tenondra/fimu_pb170_project/doc/project_documentation.docx

PB170 Záverečný projekt

Ondřej Malanik

Andrej Lipták

Našim záverečným projektom je obvod, ktorý strieda 4 farby blikaním farebných LED. Pomocou tlačidla môže užívateľ prepínať medzi štyrmi rôznymi sekvenciami blikania. Obvod je zložený z dvoch hlavných častí: Mealyho automatu a počítadla s tlačidlom.

Sekvencie farieb:

1. Červená –> Zelená –> Modrá –> Žltá
2. Červená –> Modrá –> Žltá –> Zelená
3. Všetky –> Žiadne
4. Červená + Zelená –> Modrá + Žltá –> Červená + Modrá –> Zelená + Žltá

# Postup

## Mealyho automat

Prvým krokom pre postavenie funkčného Mealyho automatu je navrhnutie vstupov, na základe ktorých sa bude obvod prepínať do rôznych sekvencií. 4 vieme realizovať pomocou dvoch vstupných premenných, I1 a I2. Stavy vstupov označíme J, K, L a M.

| I1 | I2
J | 0 | 0
K | 0 | 1
L | 1 | 0
M | 1 | 1

Automat má pre každú farbu LED výstup, t.j. Red, Green, Blue a Yellow. Urobíme tabuľku požadovaných výstupných hodnôt pre každú farebnú kombináciu. ( A = All, N = None)

| R | G | B | Y | A | N | RG | BY | RB | GY
Red | 1 | 0 | 0 | 0 | 1 | 0 | 1 | 0 | 1 | 0
Green | 0 | 1 | 0 | 0 | 1 | 0 | 1 | 0 | 0 | 1
Blue | 0 | 0 | 1 | 0 | 1 | 0 | 0 | 1 | 1 | 0
Yellow | 0 | 0 | 0 | 1 | 1 | 0 | 0 | 1 | 0 | 1

Ďalej určíme vnútorné stavy automatu. Najprv si znázorníme zmeny farebných kombinácií v závislosti na vstupoch.

J | R–>G–>B–>Y
K | R–>B–>Y–>G
L | A–>N
M | RG–>BY–>RB–>GY

Pre uľahčenie si vstup L zmeníme na A–>N –>A–>N. Dostaneme teda 4 vnútorné stavy Q1, Q2, Q3 a Q4, ktoré realizujeme pomocou dvoch klopných obvodov D, ktorých výstupy označíme D1 a D2.

| D1 | D2
Q1 | 0 | 0
Q2 | 0 | 1
Q3 | 1 | 0
Q4 | 1 | 1

Z týchto tabuliek si vieme urobiť graf prechodu:

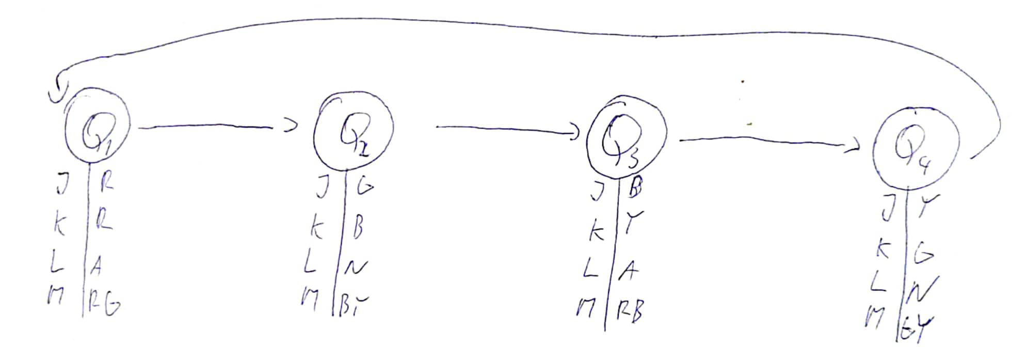
[picture p1: figure]

Skombinujeme predchádzajúce tabuľky a vytvoríme kompletnú tabuľku prechodov, vstupov a výstupov.

D1N | D2N | I1 | I2 | D1N+1 | D2N+1 | R | G | B | Y
0 | 0 | 0 | 0 | 0 | 1 | 1 | 0 | 0 | 0
0 | 1 | 0 | 0 | 1 | 0 | 0 | 1 | 0 | 0
1 | 0 | 0 | 0 | 1 | 1 | 0 | 0 | 1 | 0
1 | 1 | 0 | 0 | 0 | 0 | 0 | 0 | 0 | 1
0 | 0 | 0 | 1 | 0 | 1 | 1 | 0 | 0 | 0
0 | 1 | 0 | 1 | 1 | 0 | 0 | 0 | 1 | 0
1 | 0 | 0 | 1 | 1 | 1 | 0 | 0 | 0 | 1
1 | 1 | 0 | 1 | 0 | 0 | 0 | 1 | 0 | 0
0 | 0 | 1 | 0 | 0 | 1 | 1 | 1 | 1 | 1
0 | 1 | 1 | 0 | 1 | 0 | 0 | 0 | 0 | 0
1 | 0 | 1 | 0 | 1 | 1 | 1 | 1 | 1 | 1
1 | 1 | 1 | 0 | 0 | 0 | 0 | 0 | 0 | 0
0 | 0 | 1 | 1 | 0 | 1 | 1 | 1 | 0 | 0
0 | 1 | 1 | 1 | 1 | 0 | 0 | 0 | 1 | 1
1 | 0 | 1 | 1 | 1 | 1 | 1 | 0 | 1 | 0
1 | 1 | 1 | 1 | 0 | 0 | 0 | 1 | 0 | 1

Pomocou údajov v tabuľke zistíme funkcie pre vnútorné stavy a funkcie pre výstupy. Môžeme na to použiť napríklad Karnaughovu mapu.

Funkcie:

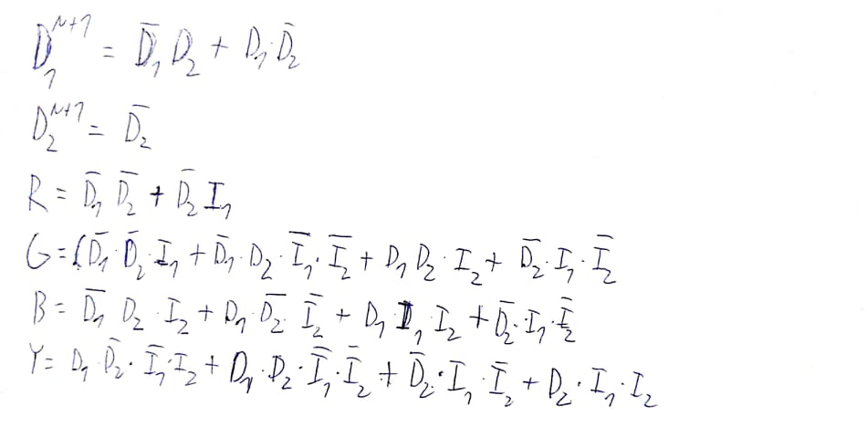
[picture p2: figure]

Posledným krokom je zostrojenie obvodu:

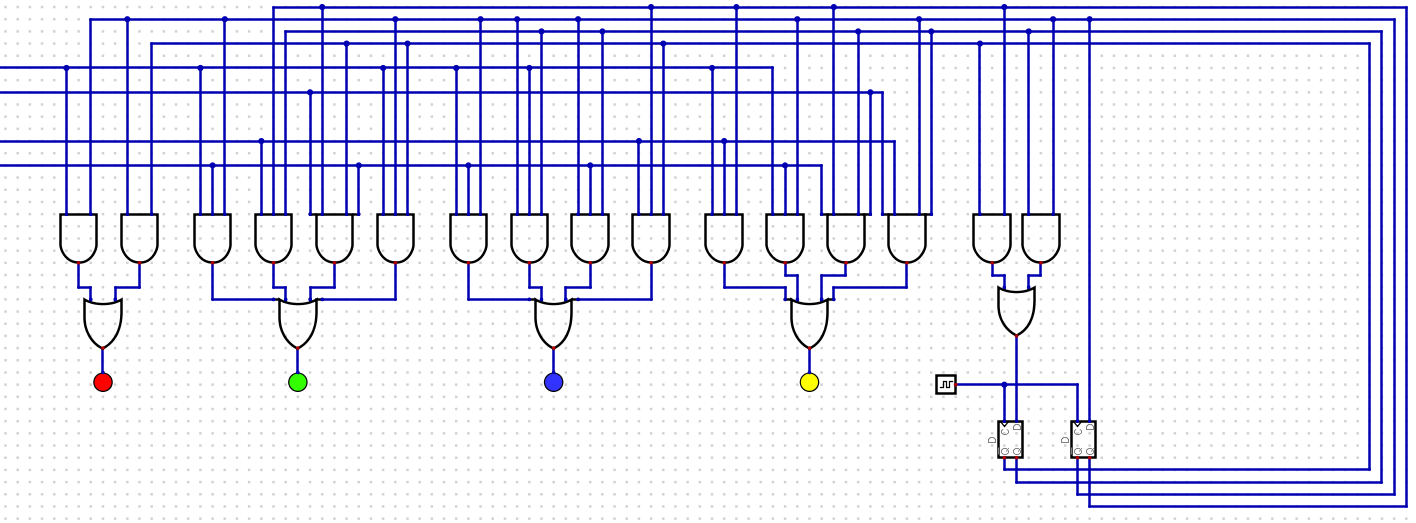
[picture p3: figure]

## Počítadlo

Keďže chceme prepínať sekvencie jedným tlačidlom, potrebujeme zostrojiť obvod, ktorý nám bude po stlačení tlačidla meniť signál následovne: 00 -> 01 -> 10 -> 11. Toto správanie dosiahneme pomocou dvoch klopných obvodov JK. Tlačidlo napojíme na hodinový signál prvého JK a výstup prvého JK privedieme na vstup hodinového signálu druhého JK. Vstupné hodnoty J a K obidvoch klopných obvodov sú nastavené na 1, čím zostrojíme prepínač výstupu na každom cykle hodinového signálu. Každé 2 prepnutia prvého JK spôsobia prepnutie druhého.

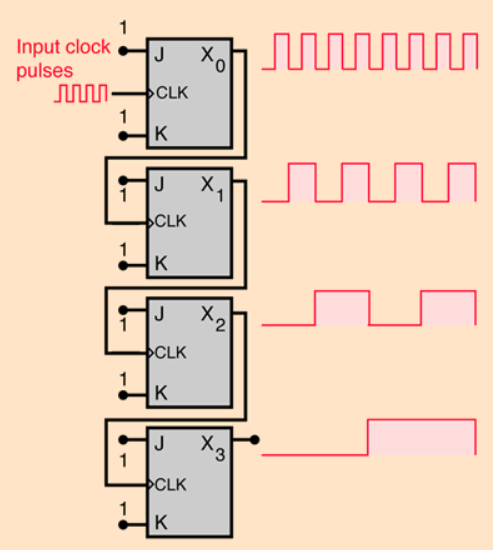
[picture p4: figure]

Zostrojíme jednoduchý obvod:

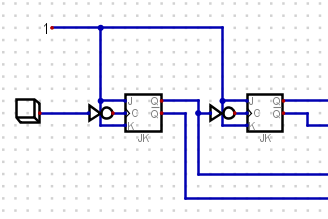
[picture p5: figure]

Finálna simulácia celého obvodu:

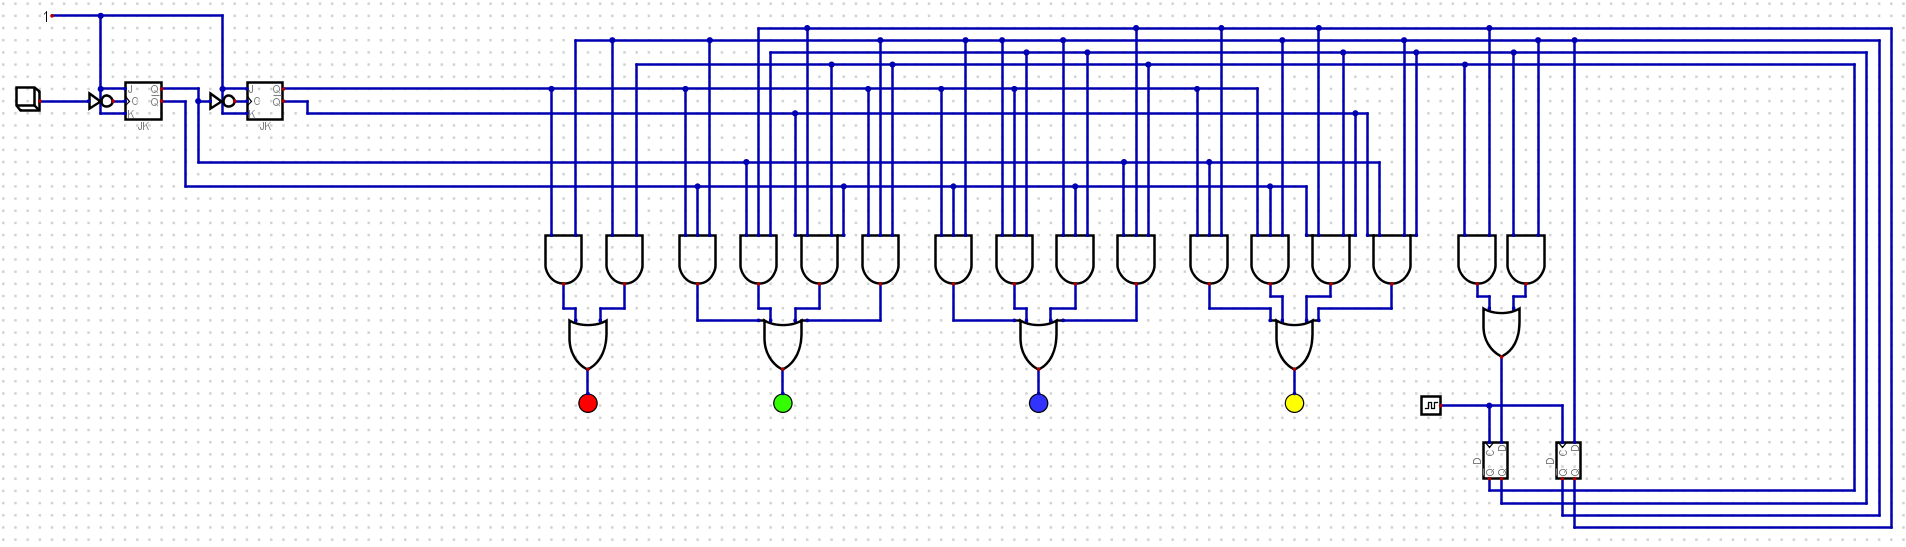
[picture p6: figure]

# KiCad

Pri vytváraní schémy v KiCade sme sa držali vyššie zobrazenej simulácie s malými zmenami. Pre každú farbu sme použili 3 LED a z dôvodu obmedzených súčiastok sme klopný obvod JK zostrojili pomocou klopného obvodu RS a dvoch AND-ov. Na zostrojenie hodinového signálu sme použili súčiastku N555 spolu s potenciometrom na úpravu frekvencie blikania.

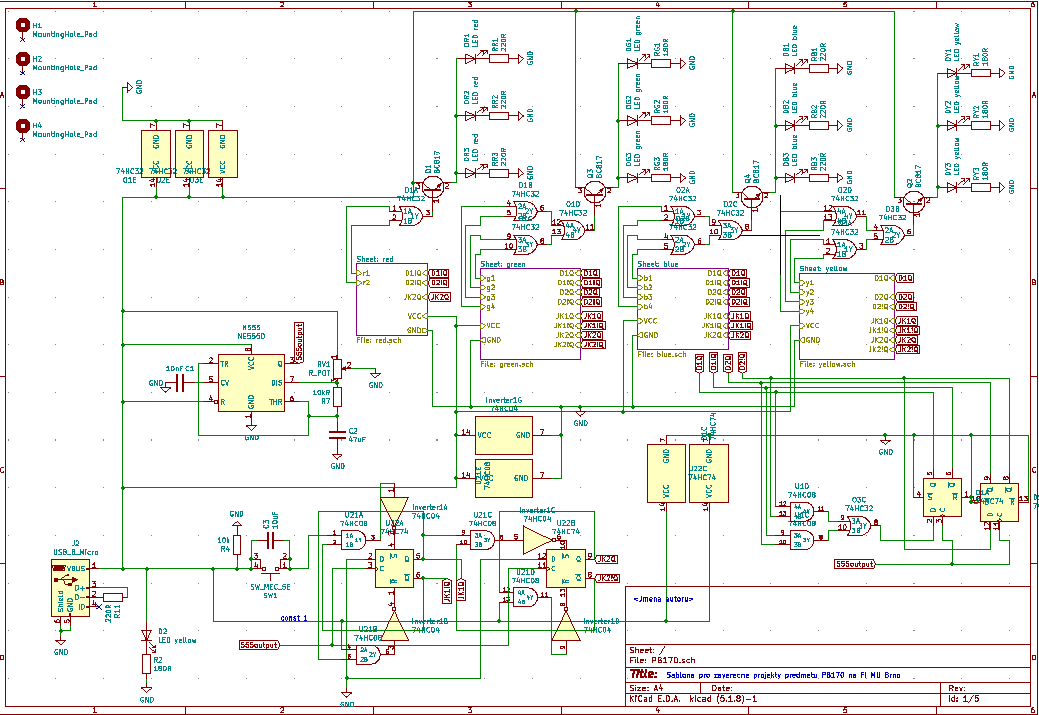
[picture p7: figure]

Zo schémy sme spravili konečnú dosku:

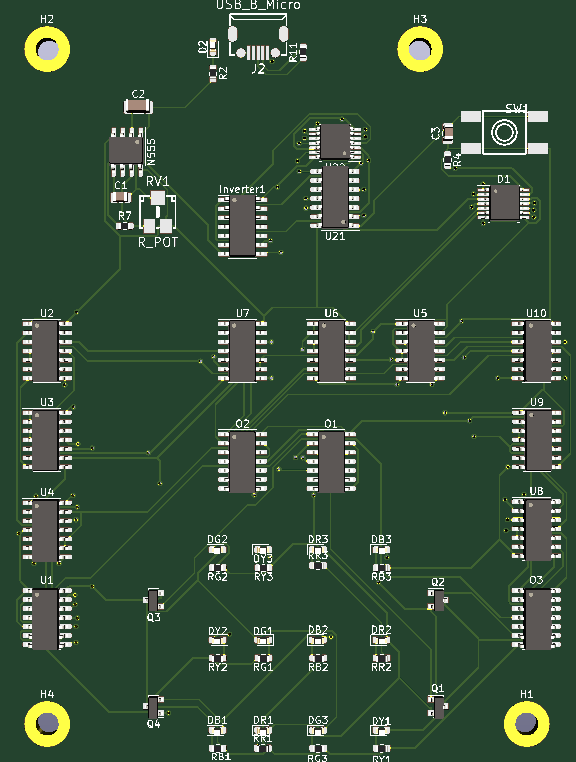
[picture p8: figure]
