tenondra/fimu_pb170_project/src/kicad/PB170.kicad_pcb

## KiCad design src/kicad/PB170.kicad_pcb (2021-02-26)

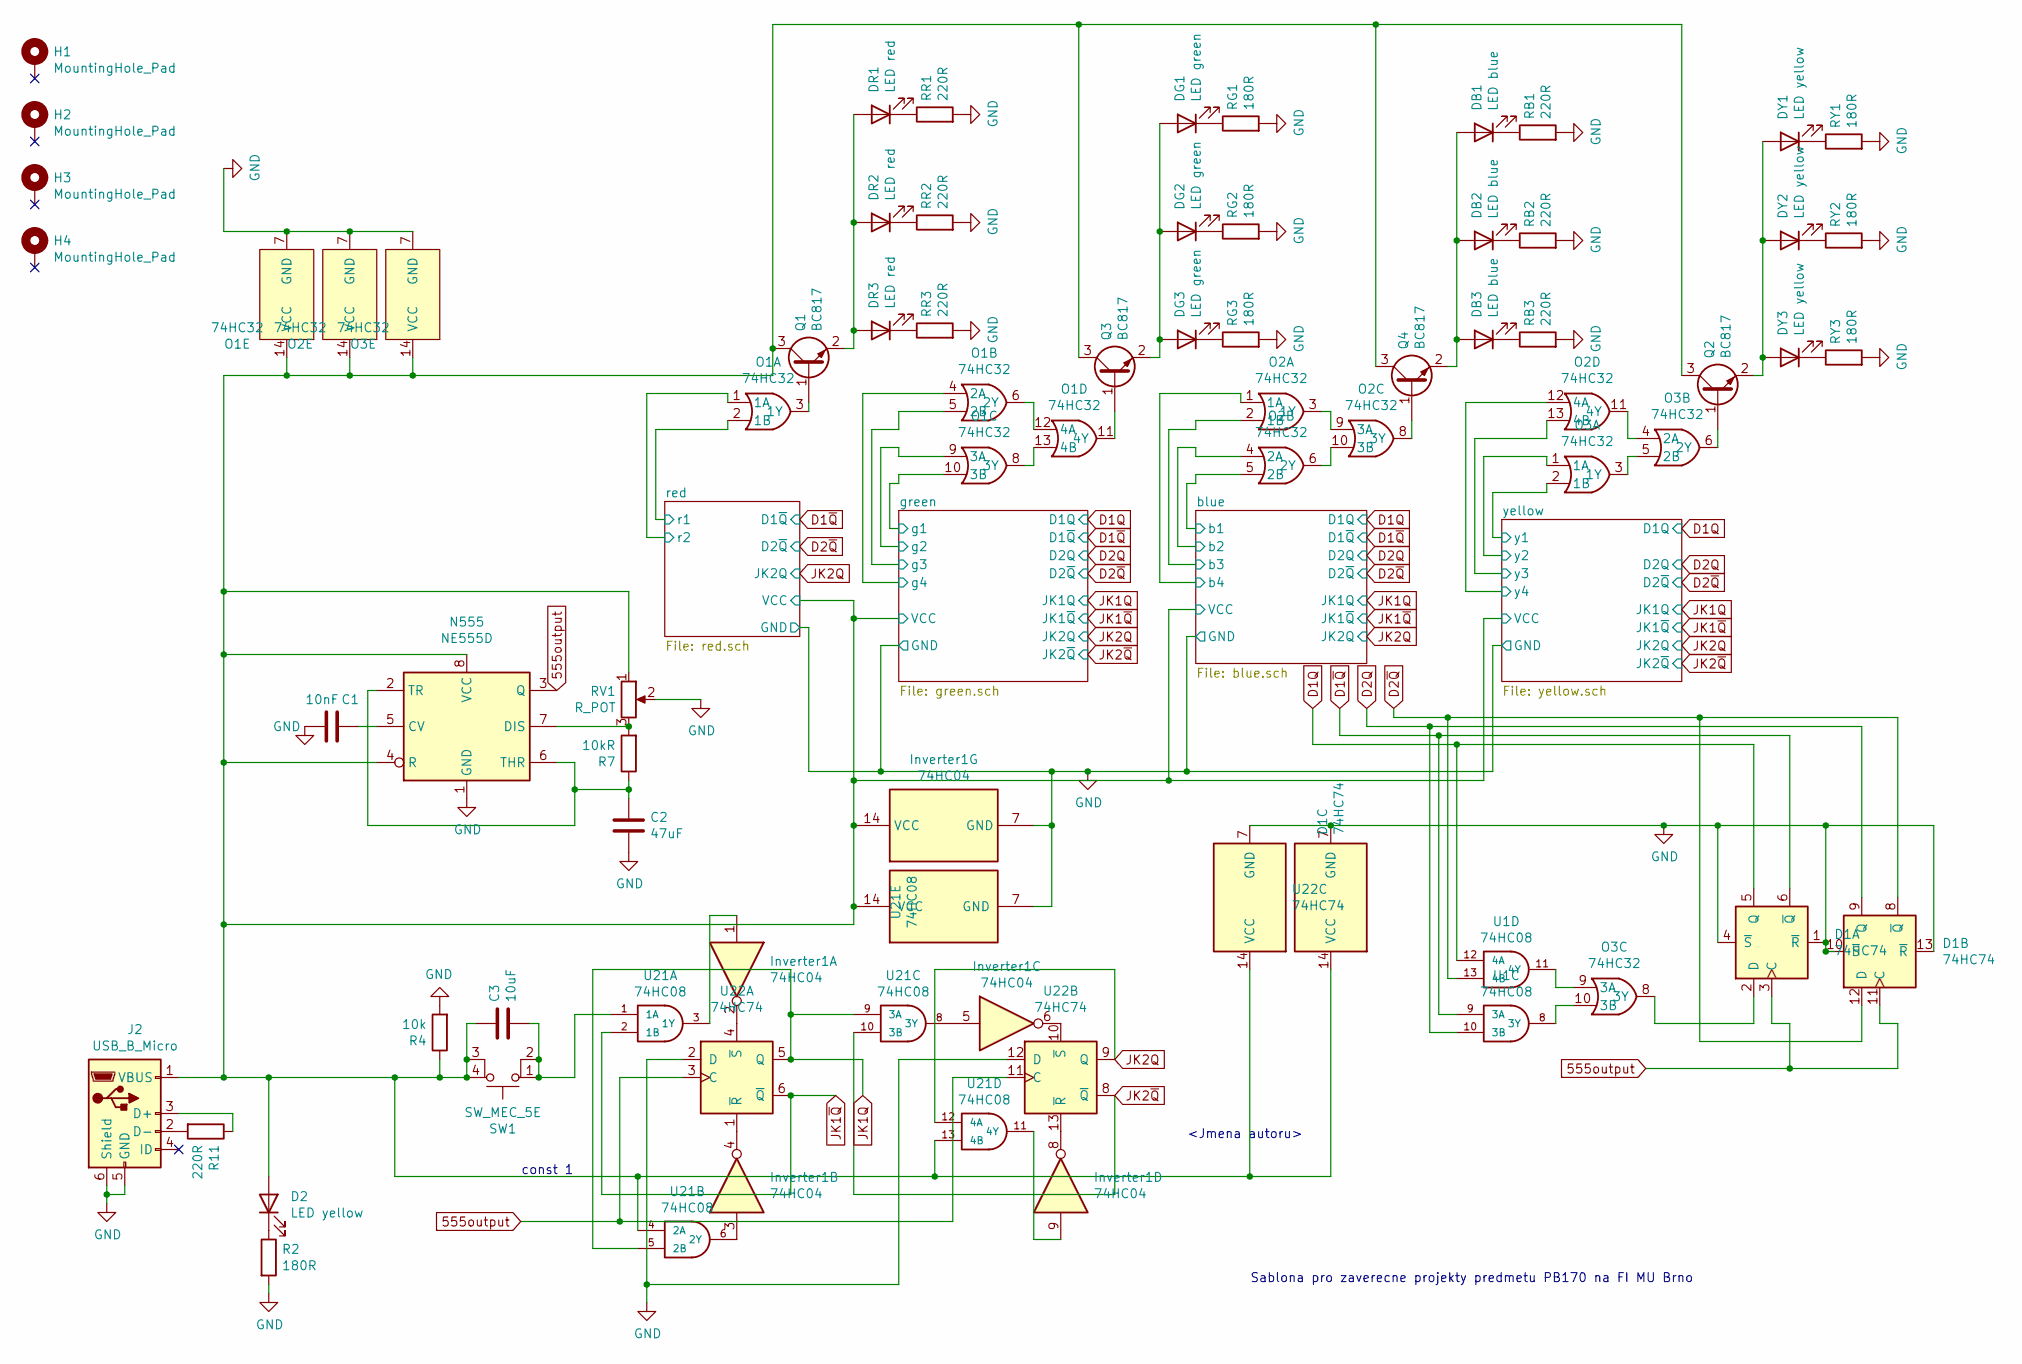
[picture p9: schematic PB170.sch]

Parts:
C1: 10nF; C_0805_2012Metric; LCSC C1710
C2: 47uF; C_1206_3216Metric; LCSC C96123
C3: 10uF; C_0805_2012Metric; LCSC C15850
D1: 74HC74; HTSSOP-14-1EP_4.4x5mm_P0.65mm_EP3.4x5mm_Mask3x3.1mm
D2: LED yellow; LED_0603_1608Metric; LCSC C72038
DB1, DB2, DB3: LED blue; LED_0603_1608Metric; LCSC C72041
DG1, DG2, DG3: LED green; LED_0603_1608Metric; LCSC C72043
DR1, DR2, DR3: LED red; LED_0603_1608Metric; LCSC C2286
DY1, DY2, DY3: LED yellow; LED_0603_1608Metric; LCSC C72038
H1, H2, H3, H4: MountingHole_Pad; MountingHole_3.2mm_M3_Pad
Inverter1: 74HC04; SOIC-14_3.9x8.7mm_P1.27mm
J2: USB_B_Micro; MICRO-USB-SMD_MICROXNJ; LCSC C404969
N555: NE555D; SOIC-8_3.9x4.9mm_P1.27mm; LCSC C7593
O1, O2, O3: 74HC32; SOIC-14_3.9x8.7mm_P1.27mm; LCSC C5632
Q1, Q2, Q3, Q4: BC817; SOT-23
R2: 180R; R_0603_1608Metric; LCSC C22828
R4: 10k; R_0603_1608Metric; LCSC C25804
R7: 10kR; R_0603_1608Metric; LCSC C25804
R11: 220R; R_0603_1608Metric; LCSC C22962
RB1, RB2, RB3: 220R; R_0603_1608Metric; LCSC C22962
RG1, RG2, RG3: 180R; R_0603_1608Metric; LCSC C22828
RR1, RR2, RR3: 220R; R_0603_1608Metric; LCSC C22962
RV1: R_POT; potentiometer10k; LCSC C132879
RY1, RY2, RY3: 180R; R_0603_1608Metric; LCSC C22828
SW1: SW_MEC_5E; TactileSwitch_C381064; LCSC C381064
U1, U21: 74HC08; SOIC-14_3.9x8.7mm_P1.27mm; LCSC C5593
U22: 74HC74; HTSSOP-14-1EP_4.4x5mm_P0.65mm_EP3.4x5mm_Mask3x3.1mm; LCSC C6761

Connections:
555output: D1.3 (C), D1.11 (C), N555.3 (Q), U22.3 (C), U22.11 (C)
/blue/VCC: C3.1, D1.14 (VCC), D2.2 (A), Inverter1.14 (VCC), J2.1 (VBUS), N555.4 (R), N555.8 (VCC), O1.14 (VCC), O2.14 (VCC), O3.14 (VCC), Q1.3 (C), Q2.3 (C), Q3.3 (C), Q4.3 (C), R4.1, RV1.1, SW1.3 (K), SW1.4 (A), U21.4 (2A), U21.13 (4B), U21.14 (VCC), U22.14 (VCC); also elsewhere on the board
/blue/b1: O2.5 (2B); also elsewhere on the board
/blue/b2: O2.4 (2A); also elsewhere on the board
/blue/b3: O2.2 (1B); also elsewhere on the board
/blue/b4: O2.1 (1A); also elsewhere on the board
/green/g1: O1.10 (3B); also elsewhere on the board
/green/g2: O1.9 (3A); also elsewhere on the board
/green/g3: O1.5 (2B); also elsewhere on the board
/green/g4: O1.4 (2A); also elsewhere on the board
/red/r1: O1.2 (1B); also elsewhere on the board
/red/r2: O1.1 (1A); also elsewhere on the board
/yellow/y1: O3.2 (1B); also elsewhere on the board
/yellow/y2: O3.1 (1A); also elsewhere on the board
/yellow/y3: O2.13 (4B); also elsewhere on the board
/yellow/y4: O2.12 (4A); also elsewhere on the board
D1Q: D1.5 (Q), U1.12 (4A); also elsewhere on the board
D1~Q: D1.6 (~Q), U1.9 (3A); also elsewhere on the board
D2Q: D1.9 (Q), U1.10 (3B); also elsewhere on the board
D2~Q: D1.8 (~Q), D1.12 (D), U1.13 (4B); also elsewhere on the board
GND: C1.2, C2.2, D1.1 (~R), D1.4 (~S), D1.7 (GND), D1.10 (~S), D1.13 (~R), Inverter1.7 (GND), J2.5 (GND), J2.6 (Shield), N555.1 (GND), O1.7 (GND), O2.7 (GND), O3.7 (GND), R2.2, R4.2, RB1.2, RB2.2, RB3.2, RG1.2, RG2.2, RG3.2, RR1.2, RR2.2, RR3.2, RV1.2, RY1.2, RY2.2, RY3.2, U21.7 (GND), U22.2 (D), U22.7 (GND), U22.12 (D); also elsewhere on the board
JK1Q: U21.5 (2B), U21.9 (3A), U22.5 (Q); also elsewhere on the board
JK1~Q: U21.2 (1B), U22.6 (~Q); also elsewhere on the board
JK2Q: U21.12 (4A), U22.9 (Q); also elsewhere on the board
JK2~Q: U21.10 (3B), U22.8 (~Q); also elsewhere on the board
unnamed: C1.1, N555.5 (CV)
unnamed: C2.1, N555.2 (TR), N555.6 (THR), R7.1
unnamed: C3.2, SW1.1, SW1.2, U21.1 (1A)
unnamed: D1.2 (D), O3.8 (3Y)
unnamed: D2.1 (K), R2.1
unnamed: DB1.1 (K), RB1.1
unnamed: DB1.2 (A), DB2.2 (A), DB3.2 (A), Q4.2 (E)
unnamed: DB2.1 (K), RB2.1
unnamed: DB3.1 (K), RB3.1
unnamed: DG1.1 (K), RG1.1
unnamed: DG1.2 (A), DG2.2 (A), DG3.2 (A), Q3.2 (E)
unnamed: DG2.1 (K), RG2.1
unnamed: DG3.1 (K), RG3.1
unnamed: DR1.1 (K), RR1.1
unnamed: DR1.2 (A), DR2.2 (A), DR3.2 (A), Q1.2 (E)
unnamed: DR2.1 (K), RR2.1
unnamed: DR3.1 (K), RR3.1
unnamed: DY1.1 (K), RY1.1
unnamed: DY1.2 (A), DY2.2 (A), DY3.2 (A), Q2.2 (E)
unnamed: DY2.1 (K), RY2.1
unnamed: DY3.1 (K), RY3.1
unnamed: Inverter1.1, U21.3 (1Y)
unnamed: Inverter1.2, U22.4 (~S)
unnamed: Inverter1.3, U21.6 (2Y)
unnamed: Inverter1.4, U22.1 (~R)
unnamed: Inverter1.5, U21.8 (3Y)
unnamed: Inverter1.6, U22.10 (~S)
unnamed: Inverter1.8, U22.13 (~R)
unnamed: Inverter1.9, U21.11 (4Y)
unnamed: J2.2 (D-), R11.2
unnamed: J2.3 (D+), R11.1
unnamed: N555.7 (DIS), R7.2, RV1.3
unnamed: O1.3 (1Y), Q1.1 (B)
unnamed: O1.11 (4Y), Q3.1 (B)
unnamed: O1.6 (2Y), O1.12 (4A)
unnamed: O1.8 (3Y), O1.13 (4B)
unnamed: O2.3 (1Y), O2.9 (3A)
unnamed: O2.8 (3Y), Q4.1 (B)
unnamed: O2.6 (2Y), O2.10 (3B)
unnamed: O2.11 (4Y), O3.4 (2A)
unnamed: O3.3 (1Y), O3.5 (2B)
unnamed: O3.6 (2Y), Q2.1 (B)
unnamed: O3.9 (3A), U1.11 (4Y)
unnamed: O3.10 (3B), U1.8 (3Y)

Notes on the sheet:
Sablona pro zaverecne projekty predmetu PB170 na FI MU Brno
<Jmena autoru>
const 1

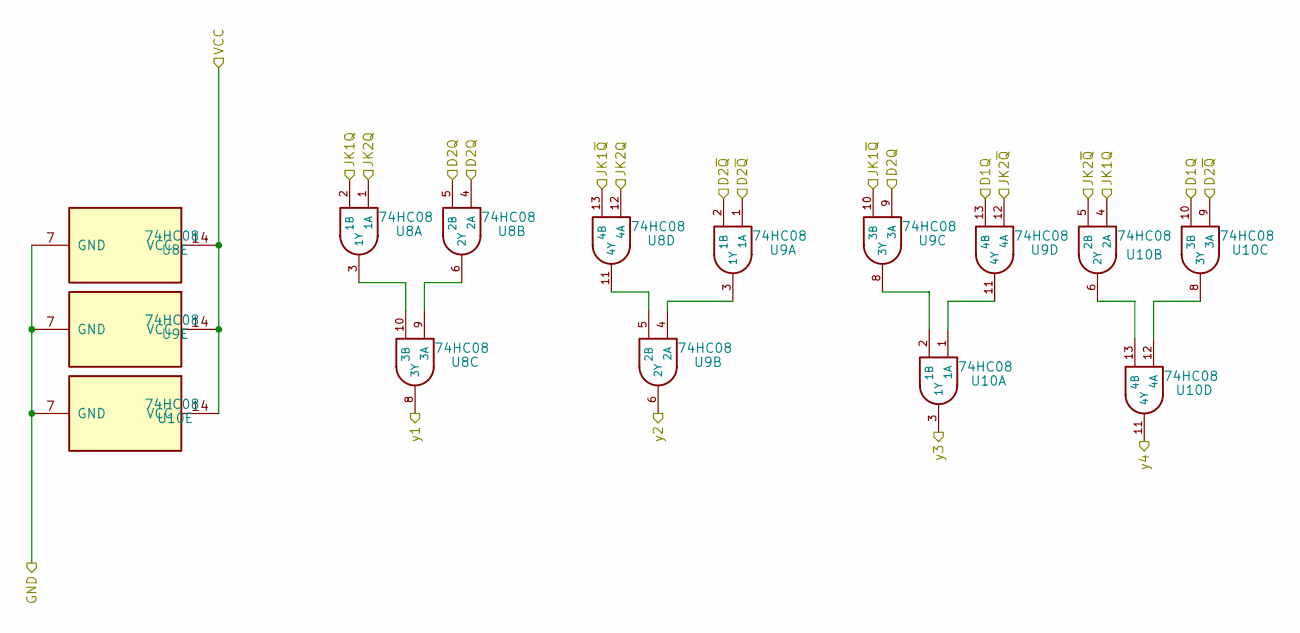
[picture p10: schematic yellow.sch]

Parts:
U8, U9, U10: 74HC08; SOIC-14_3.9x8.7mm_P1.27mm; LCSC C5593

Connections:
/blue/VCC: U8.14 (VCC), U9.14 (VCC), U10.14 (VCC); also elsewhere on the board
/yellow/y1: U8.8 (3Y); also elsewhere on the board
/yellow/y2: U9.6 (2Y); also elsewhere on the board
/yellow/y3: U10.3 (1Y); also elsewhere on the board
/yellow/y4: U10.11 (4Y); also elsewhere on the board
D1Q: U9.13 (4B), U10.10 (3B); also elsewhere on the board
D2Q: U8.4 (2A), U8.5 (2B), U9.9 (3A); also elsewhere on the board
D2~Q: U9.1 (1A), U9.2 (1B), U10.9 (3A); also elsewhere on the board
GND: U8.7 (GND), U9.7 (GND), U10.7 (GND); also elsewhere on the board
JK1Q: U8.2 (1B), U10.4 (2A); also elsewhere on the board
JK1~Q: U8.13 (4B), U9.10 (3B); also elsewhere on the board
JK2Q: U8.1 (1A), U8.12 (4A); also elsewhere on the board
JK2~Q: U9.12 (4A), U10.5 (2B); also elsewhere on the board
unnamed: U8.6 (2Y), U8.9 (3A)
unnamed: U8.3 (1Y), U8.10 (3B)
unnamed: U8.11 (4Y), U9.5 (2B)
unnamed: U9.3 (1Y), U9.4 (2A)
unnamed: U9.11 (4Y), U10.1 (1A)
unnamed: U9.8 (3Y), U10.2 (1B)
unnamed: U10.8 (3Y), U10.12 (4A)
unnamed: U10.6 (2Y), U10.13 (4B)

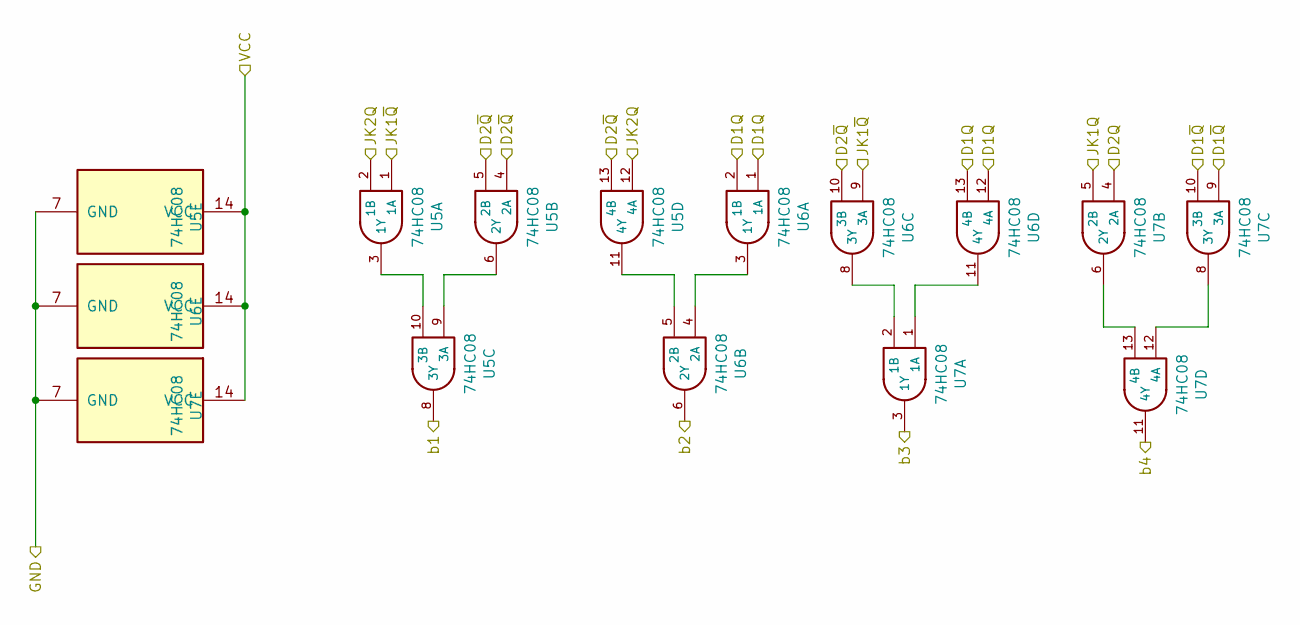
[picture p11: schematic blue.sch]

Parts:
U5, U6, U7: 74HC08; SOIC-14_3.9x8.7mm_P1.27mm; LCSC C5593

Connections:
/blue/VCC: U5.14 (VCC), U6.14 (VCC), U7.14 (VCC); also elsewhere on the board
/blue/b1: U5.8 (3Y); also elsewhere on the board
/blue/b2: U6.6 (2Y); also elsewhere on the board
/blue/b3: U7.3 (1Y); also elsewhere on the board
/blue/b4: U7.11 (4Y); also elsewhere on the board
D1Q: U6.1 (1A), U6.2 (1B), U6.12 (4A), U6.13 (4B); also elsewhere on the board
D1~Q: U7.9 (3A), U7.10 (3B); also elsewhere on the board
D2Q: U7.4 (2A); also elsewhere on the board
D2~Q: U5.4 (2A), U5.5 (2B), U5.13 (4B), U6.10 (3B); also elsewhere on the board
GND: U5.7 (GND), U6.7 (GND), U7.7 (GND); also elsewhere on the board
JK1Q: U7.5 (2B); also elsewhere on the board
JK1~Q: U5.1 (1A), U6.9 (3A); also elsewhere on the board
JK2Q: U5.2 (1B), U5.12 (4A); also elsewhere on the board
unnamed: U5.6 (2Y), U5.9 (3A)
unnamed: U5.3 (1Y), U5.10 (3B)
unnamed: U5.11 (4Y), U6.5 (2B)
unnamed: U6.3 (1Y), U6.4 (2A)
unnamed: U6.8 (3Y), U7.2 (1B)
unnamed: U6.11 (4Y), U7.1 (1A)
unnamed: U7.8 (3Y), U7.12 (4A)
unnamed: U7.6 (2Y), U7.13 (4B)

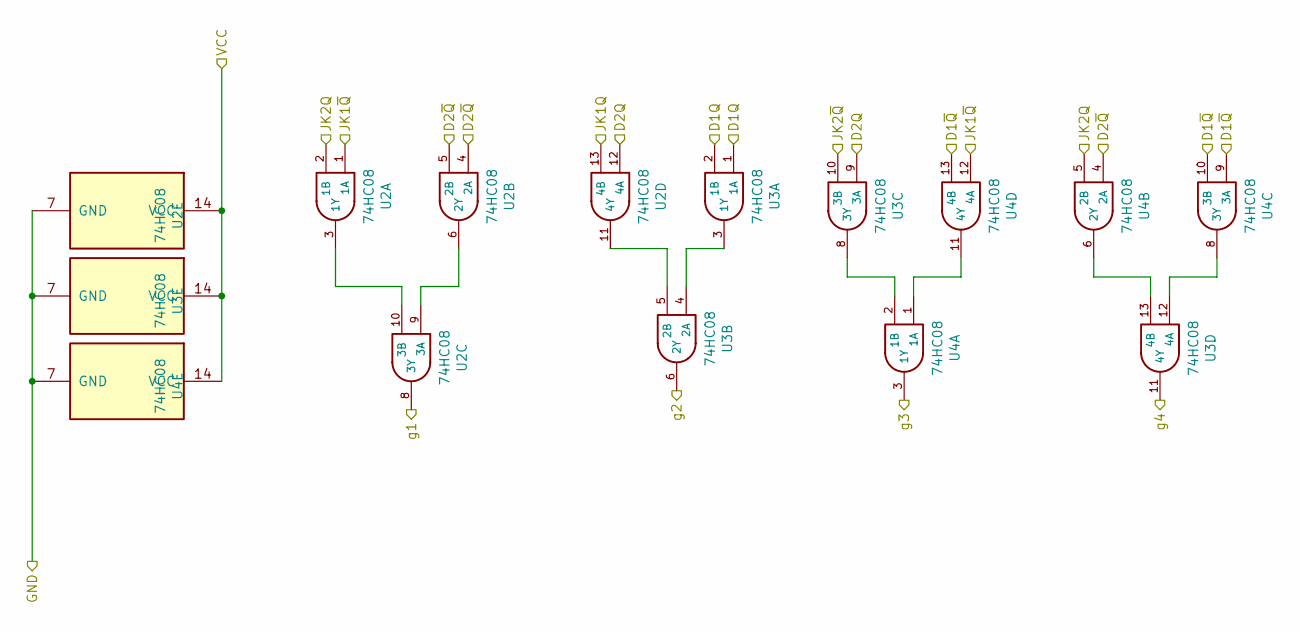
[picture p12: schematic green.sch]

Parts:
U2, U3, U4: 74HC08; SOIC-14_3.9x8.7mm_P1.27mm; LCSC C5593

Connections:
/blue/VCC: U2.14 (VCC), U3.14 (VCC), U4.14 (VCC); also elsewhere on the board
/green/g1: U2.8 (3Y); also elsewhere on the board
/green/g2: U3.6 (2Y); also elsewhere on the board
/green/g3: U4.3 (1Y); also elsewhere on the board
/green/g4: U3.11 (4Y); also elsewhere on the board
D1Q: U3.1 (1A), U3.2 (1B); also elsewhere on the board
D1~Q: U4.9 (3A), U4.10 (3B), U4.13 (4B); also elsewhere on the board
D2Q: U2.12 (4A), U3.9 (3A); also elsewhere on the board
D2~Q: U2.4 (2A), U2.5 (2B), U4.4 (2A); also elsewhere on the board
GND: U2.7 (GND), U3.7 (GND), U4.7 (GND); also elsewhere on the board
JK1Q: U2.13 (4B); also elsewhere on the board
JK1~Q: U2.1 (1A), U4.12 (4A); also elsewhere on the board
JK2Q: U2.2 (1B), U4.5 (2B); also elsewhere on the board
JK2~Q: U3.10 (3B); also elsewhere on the board
unnamed: U2.6 (2Y), U2.9 (3A)
unnamed: U2.3 (1Y), U2.10 (3B)
unnamed: U2.11 (4Y), U3.5 (2B)
unnamed: U3.3 (1Y), U3.4 (2A)
unnamed: U3.8 (3Y), U4.2 (1B)
unnamed: U3.12 (4A), U4.8 (3Y)
unnamed: U3.13 (4B), U4.6 (2Y)
unnamed: U4.1 (1A), U4.11 (4Y)

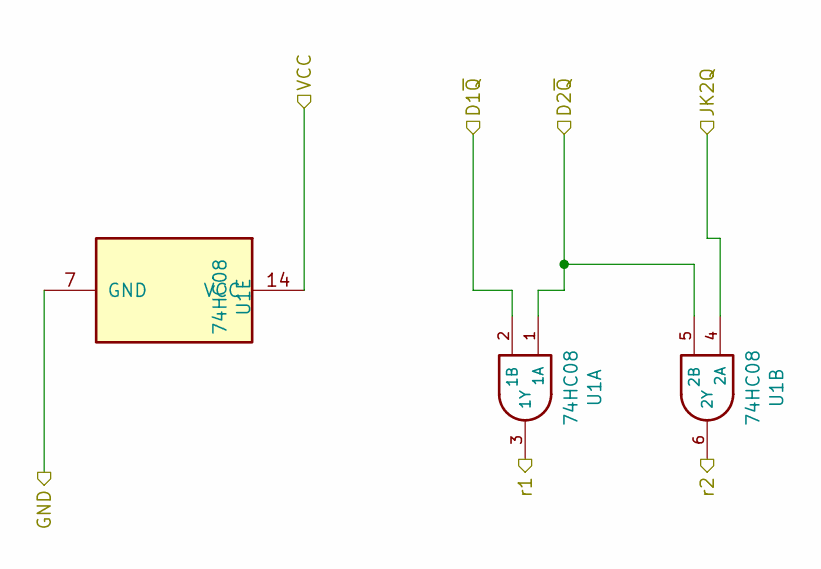
[picture p13: schematic red.sch]

Parts:
U1: 74HC08; SOIC-14_3.9x8.7mm_P1.27mm; LCSC C5593

Connections:
/blue/VCC: U1.14 (VCC); also elsewhere on the board
/red/r1: U1.3 (1Y); also elsewhere on the board
/red/r2: U1.6 (2Y); also elsewhere on the board
D1~Q: U1.2 (1B); also elsewhere on the board
D2~Q: U1.1 (1A), U1.5 (2B); also elsewhere on the board
GND: U1.7 (GND); also elsewhere on the board
JK2Q: U1.4 (2A); also elsewhere on the board

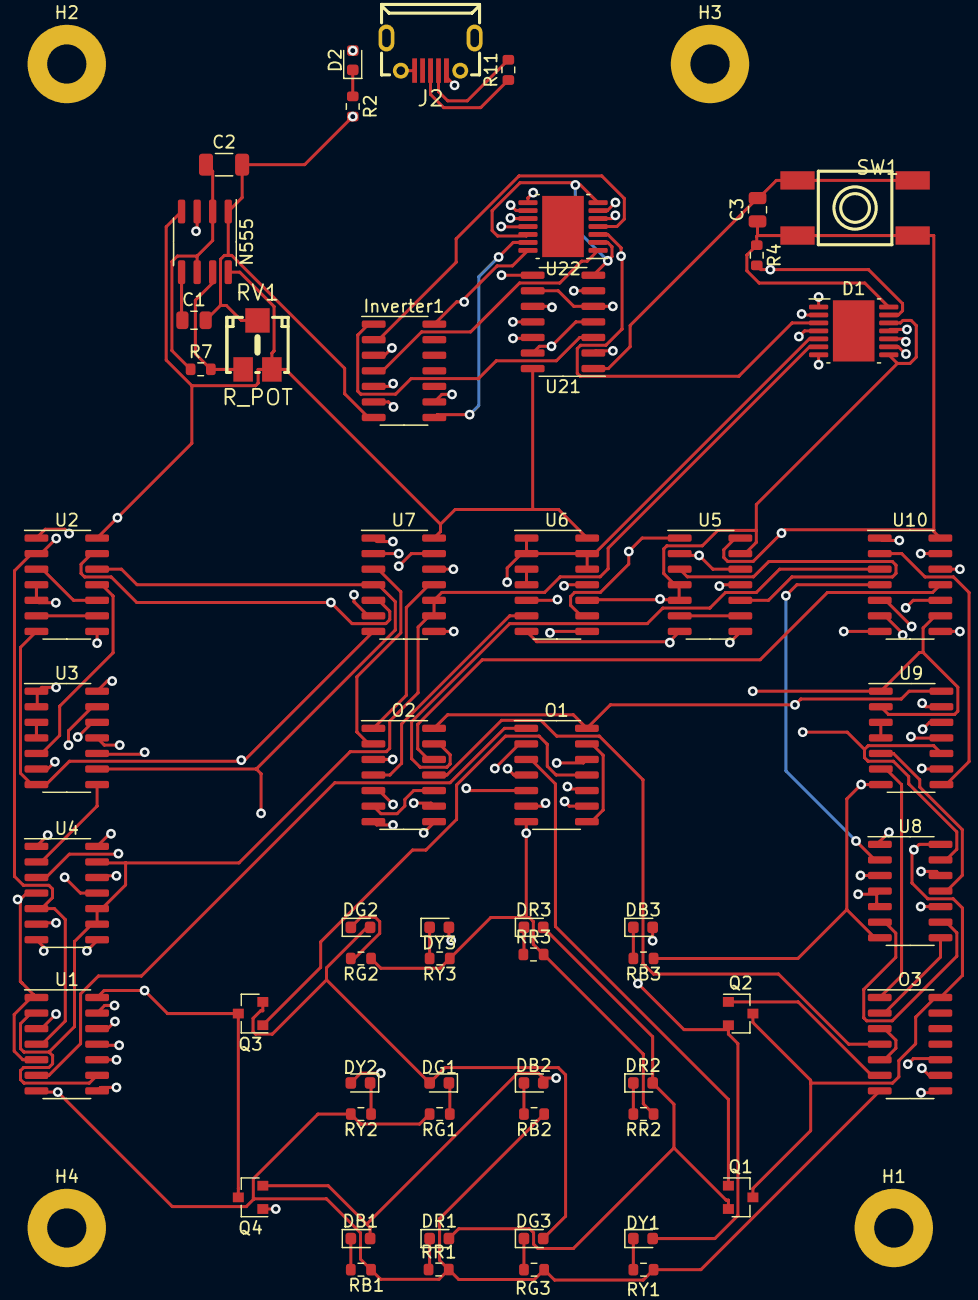
[picture p14: board PB170.kicad_pcb from above]

Board: 4 copper layers, 61 parts (0 on the bottom side), 93 nets.
