tenondra/fimu_pb170_project/(commit log)

2021-01-03 Added one button switch instead two buttons
2021-01-03 Added kicad template from PB170
    [PB170.kicad_pcb, PB170.sch, newParts.sch, xor.sch]
2021-01-06 First KiCad trials
    [PB170.sch, newParts.sch]
2021-01-06 added basic circuit layout
    [PB170.sch, and.kicad_pcb, and.sch, newParts.sch]
2021-01-07 Corrected .digi project
    [newParts.sch]
2021-01-07 Changed logical OR components
    [PB170.sch, and.kicad_pcb, and.sch]
2021-01-09 new OR
    [PB170.sch]
2021-01-10 added sub-schemes
    [PB170.sch, blue.sch, green.sch, newParts.sch, red.sch, redAnd.sch, yellow.sch]
2021-01-11 finished sub-schemes for LEDs
    [PB170.sch, blue.sch, green.sch, red.sch, yellow.sch]
2021-02-04 added OR gates
    [PB170.sch, newParts.sch, yellow.sch]
2021-02-04 added D flip flops
    [PB170.sch, newParts.sch]
2021-02-04 D flops edit
    [PB170.sch]
2021-02-07 555 clk implementation
    [PB170.sch]
2021-02-07 fixed annotaion
    [PB170.sch, blue.sch, green.sch, red.sch, yellow.sch]
2021-02-08 Fixed wires under parts - removed
    [PB170.sch]
2021-02-15 Partially fixed footprint library and reassigning references
    [PB170.sch, red.sch]
2021-02-15 added annotations, power connections to parts
    [PB170.kicad_pcb, PB170.sch, blue.sch, green.sch, red.sch, yellow.sch]
2021-02-16 finished eeschema
    [PB170.sch]
2021-02-17 Hopefully finished eeschema, added inverters for rs flip flops
    [PB170.kicad_pcb, PB170.sch]
2021-02-17 removed connections from pcbnew - restarting..
    [PB170.kicad_pcb]
2021-02-17 routing finished
    [PB170.kicad_pcb, PB170.sch]
2021-02-17 resolved push colisions
    [PB170.kicad_pcb, PB170.sch]
2021-02-19 Deleted obsolete files
    [and.kicad_pcb, and.sch, newParts.sch, redAnd.sch, xor.sch]
2021-02-19 Corrected negations
    [PB170.kicad_pcb, PB170.sch, blue.sch, green.sch, red.sch, yellow.sch]
2021-02-26 fixed micro-usb connection, rotated the whole thing
    [PB170.kicad_pcb]
